yassan802/DRC-SerialSVMD2026.ver.0.2.1/README.md

STS3215等のシリアルバスサーボを動かすための基板。ver.0.1.2からの変更点としては、基板サイズが45*60mmになったこと、マイコンがRP2354Aになったこと、動力用電源に5Vを使用できることなどがあげられる。  
ver.0.1.2 → https://github.com/kotek-7/DRC-SerialSVMD2026/　　
スクリーンショット 2026-10-23 212213
