yassan802/DRC-SerialSVMD2026.ver.0.2.1/PCBA用BOM・CPL/bom.csv

Designator | Footprint | Quantity | Value | LCSC Part #
C19, C22, C24 | 0603 | 3 | 4.7uF | C19666
C20, C21 | 0402 | 2 | 15p | C1548
L1 | abracon_aota-b201610s3r3-101-t | 1 | AOTA-B201610S3R3-101-T | C42411119
Q1 | SOT-23-3 | 1 | MMBT3906 | C7420354
R1, R2 | 0603 | 2 | 27R | C25190
R3 | 0402 | 1 | 33R | C25105
R4 | 0402 | 1 | 1k | C11702
SW1, SW2 | SW_TS-1088-AR02016 | 2 | TS-1088-AR02016 | C720477
U2 | SOT-89-3 | 1 | 78L05G-AB3-R | C71136
U3 | SOIC-8_3.9x4.9mm_P1.27mm | 1 | Si8621EC-B-IS | C7010821
U5 | QFN-60-1EP_7x7mm_P0.4mm_EP3.4x3.4mm_ThermalVias | 1 | RP2354A | C41378174
U6 | SOIC-8_3.9x4.9mm_P1.27mm | 1 | SN65HVD230DR | C12084
Y1 | generic_xtalcc320x250x80-4 | 1 | ABM8-272-T3 | C20625731
