yassan802/DRC-SerialSVMD2026.ver.0.2.1/DRC-SerialSVMD2026.ver.0.2.1.pdf

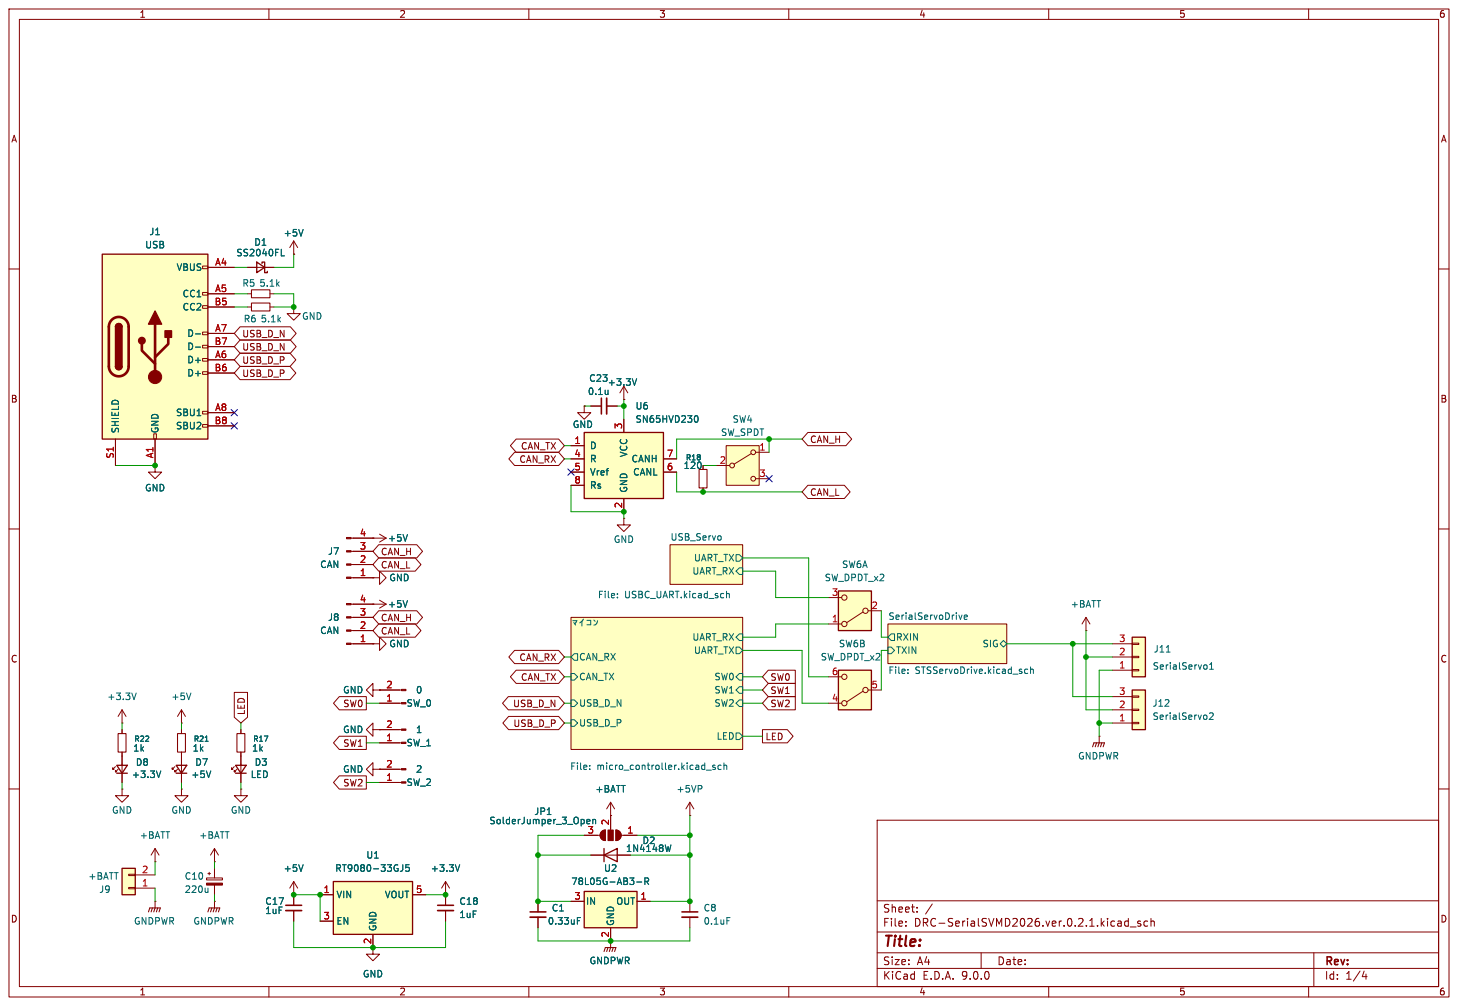
[picture p1: page 1]

Id: 1/4 Title: File: DRC-SerialSVMD2026.ver.0.2.1.kicad_sch Sheet: / RXIN

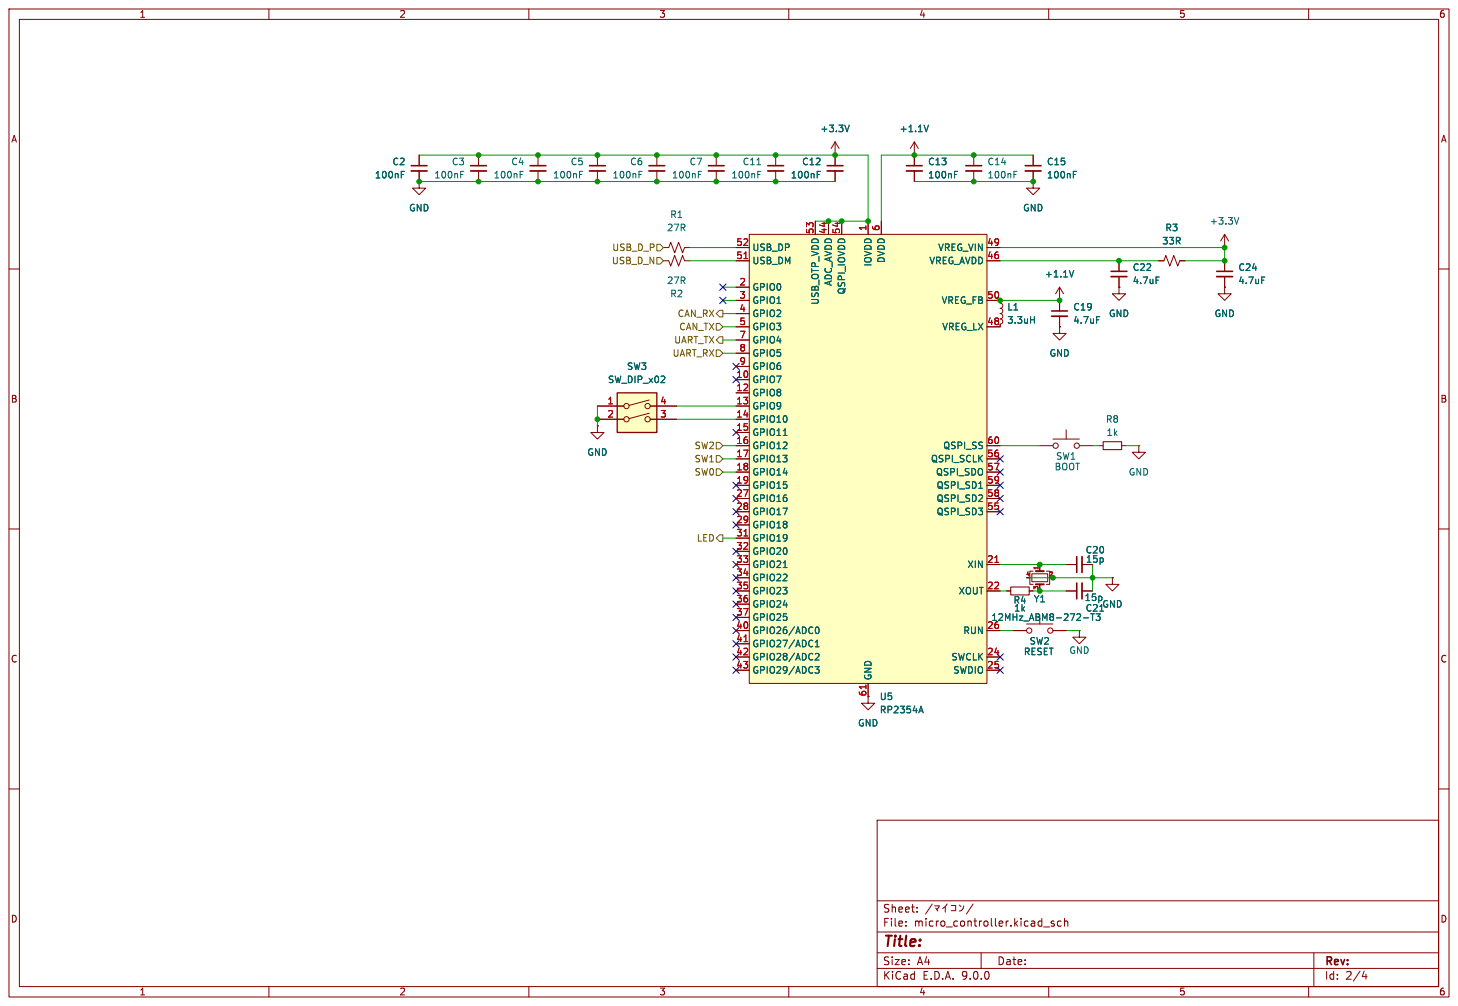
[picture p2: page 2]

Id: 2/4 Title: File: micro_controller.kicad_sch Sheet: þÿ/0Þ0¤0³0ó/ GND

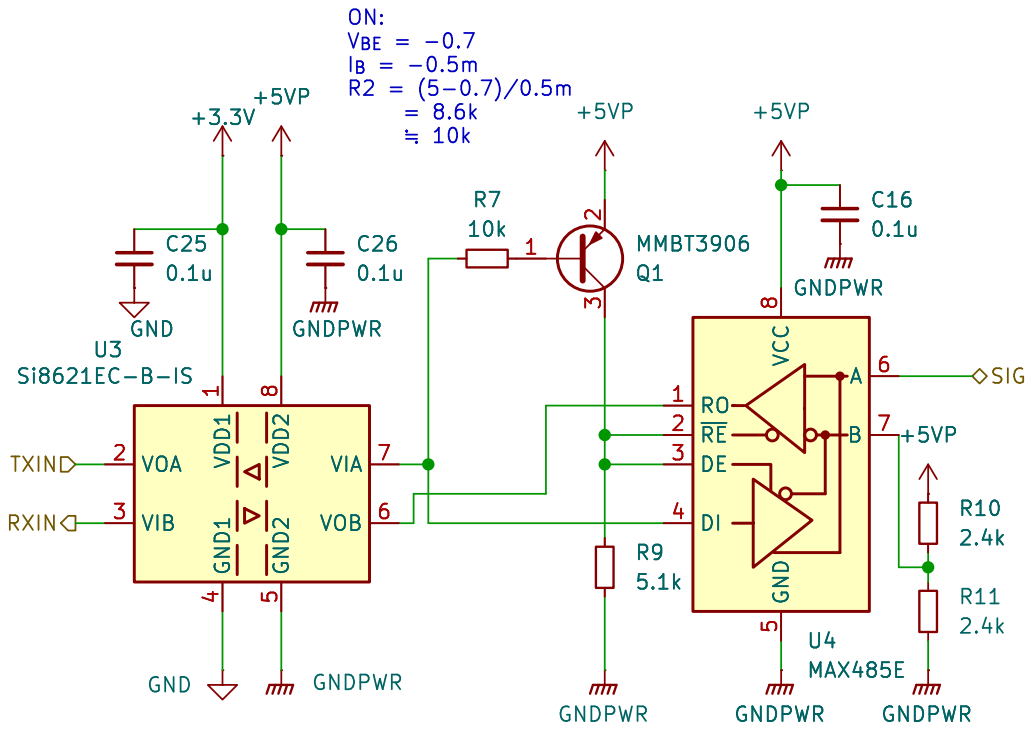
[picture p3: page 3]

3 2 U4 MAX485E RO 1 ~{RE} 2 DE 3 DI 4 VCC

5 VIA 7 VOB 6 U3 Si8621EC-B-IS GNDPWR

Id: 3/4 Title: File: STSServoDrive.kicad_sch Sheet: /SerialServoDrive/

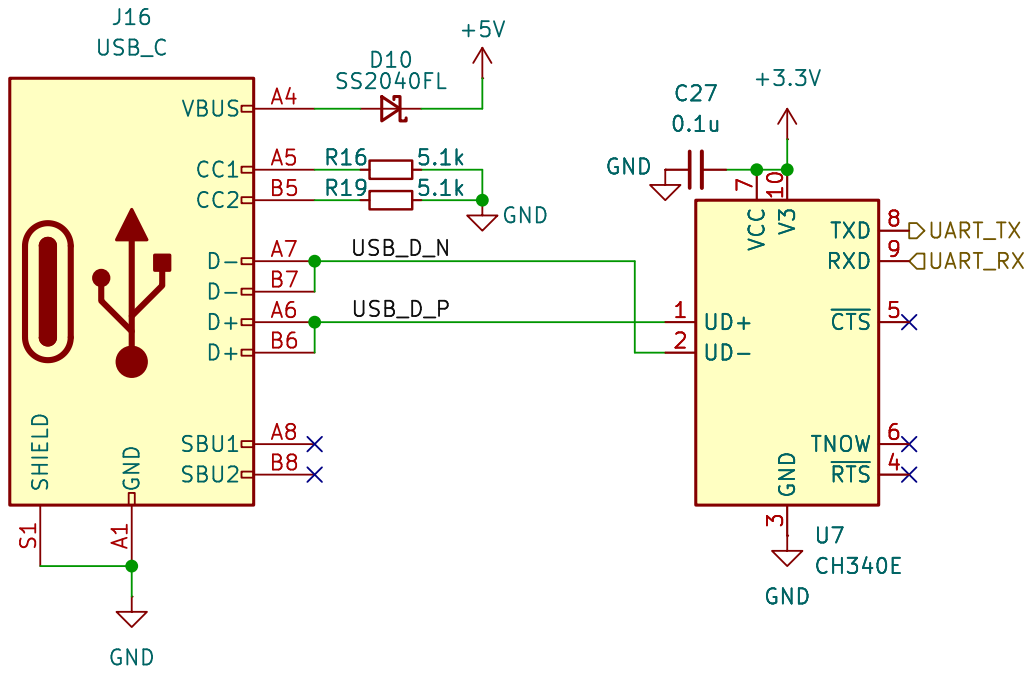
[picture p4: page 4]

3 TXD 8 RXD 9 ~{CTS}5 TNOW 6 ~{RTS}4 U7 CH340E R16 5.1k GND GND SHIELD S1 GND A1 VBUS A4 CC1 A5 CC2 B5 D- A7 D- B7 D+ A6 D+ B6 SBU1 A8 SBU2 B8

3 TXD 8 RXD 9 ~{CTS}5 TNOW 6 ~{RTS}4

Id: 4/4 Title: File: USBC_UART.kicad_sch Sheet: /USB_Servo/
