yassan802/DRC-SerialSVMD2026.ver.0.2.1/DRC-SerialSVMD2026.ver.0.2.1.kicad_pcb

## KiCad design DRC-SerialSVMD2026.ver.0.2.1.kicad_pcb (2026-10-23)

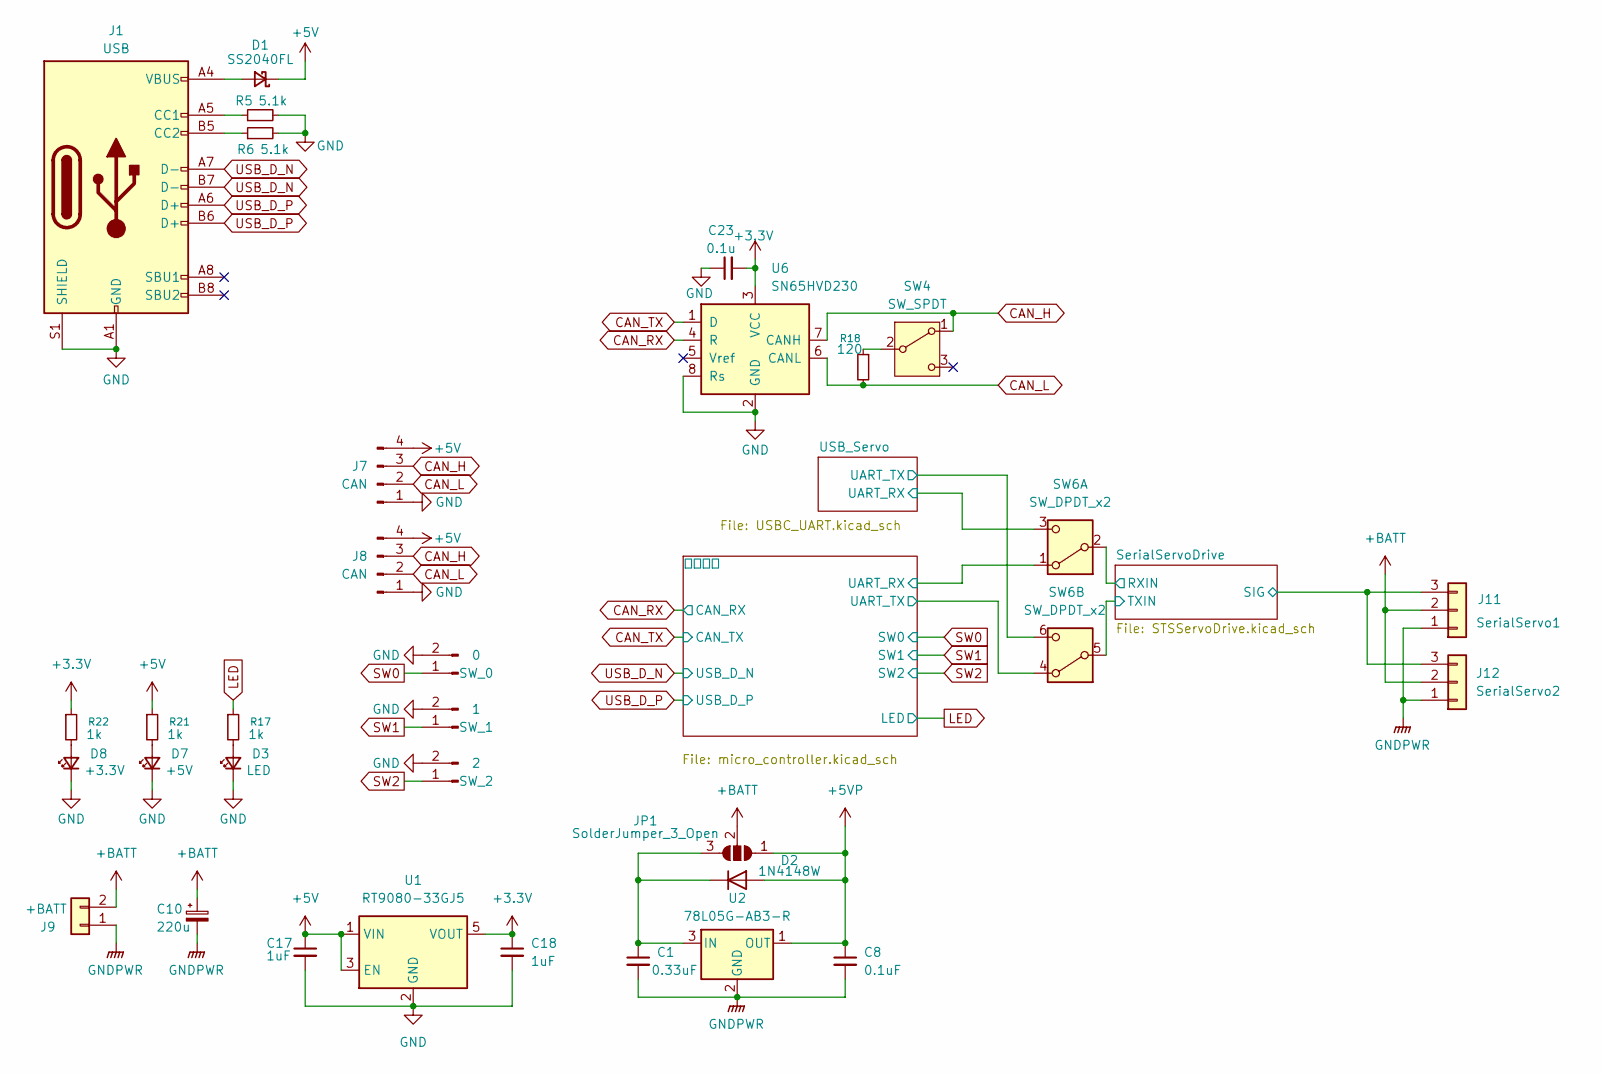
[picture p5: schematic DRC-SerialSVMD2026.ver.0.2.1.kicad_sch]

Parts:
C1: 0.33uF; C_0603_1608Metric_Pad1.08x0.95mm_HandSolder
C8: 0.1uF; C_0603_1608Metric_Pad1.08x0.95mm_HandSolder
C10: 220u; CP_Radial_D8.0mm_P3.50mm
C17, C18: 1uF; C_0603_1608Metric_Pad1.08x0.95mm_HandSolder
C23: 0.1u; C_0603_1608Metric_Pad1.08x0.95mm_HandSolder
D1: SS2040FL; D_SOD-123F
D2: 1N4148W; D_SOD-123
D3: LED; LED_0603_1608Metric_Pad1.05x0.95mm_HandSolder
D7: +5V; LED_0603_1608Metric_Pad1.05x0.95mm_HandSolder
D8: +3.3V; LED_0603_1608Metric_Pad1.05x0.95mm_HandSolder
J1: USB; USB_C_Receptacle_GCT_USB4105-xx-A_16P_TopMnt_Horizontal
J7, J8: CAN; JST_XH_S4B-XH-A_1x04_P2.50mm_Horizontal
J9: +BATT; AMASS_XT30PW-M_1x02_P2.50mm_Horizontal
J11: SerialServo1; JST_XH_S3B-XH-A_1x03_P2.50mm_Horizontal
J12: SerialServo2; JST_XH_S3B-XH-A_1x03_P2.50mm_Horizontal
JP1: SolderJumper_3_Open; SolderJumper-3_P1.3mm_Open_RoundedPad1.0x1.5mm_NumberLabels
R5, R6: 5.1k; R_0603_1608Metric_Pad0.98x0.95mm_HandSolder
R17, R21, R22: 1k; R_0603_1608Metric_Pad0.98x0.95mm_HandSolder
R18: 120; R_0603_1608Metric_Pad0.98x0.95mm_HandSolder
SW4: SW_SPDT; SW_Slide_SS-12D00G3_1P2T_P2.50mm
SW6: SW_DPDT_x2; IS-2235-G
SW_0: 0; JST_XH_B2B-XH-A_1x02_P2.50mm_Vertical
SW_1: 1; JST_XH_B2B-XH-A_1x02_P2.50mm_Vertical
SW_2: 2; JST_XH_B2B-XH-A_1x02_P2.50mm_Vertical
U1: RT9080-33GJ5; TSOT-23-5_HandSoldering
U2: 78L05G-AB3-R; SOT-89-3
U6: SN65HVD230; SOIC-8_3.9x4.9mm_P1.27mm

Connections:
+3.3V: C18.1, C23.2, R22.1, U1.5 (VOUT), U6.3 (VCC); also elsewhere on the board
+5V: C17.1, D1.1 (K), J7.4, J8.4, R21.1, U1.1 (VIN), U1.3 (EN); also elsewhere on the board
+5VP: C8.1, D2.2 (A), JP1.1 (A), U2.1 (OUT); also elsewhere on the board
+BATT: C10.1, J9.2, J11.2, J12.2, JP1.2 (C)
/SerialServoDrive/RXIN: SW6.2 (B); also elsewhere on the board
/SerialServoDrive/SIG: J11.3, J12.3; also elsewhere on the board
/SerialServoDrive/TXIN: SW6.5 (B); also elsewhere on the board
/USB_Servo/UART_RX: SW6.3 (C); also elsewhere on the board
/USB_Servo/UART_TX: SW6.6 (C); also elsewhere on the board
/マイコン/UART_RX: SW6.1 (A); also elsewhere on the board
/マイコン/UART_TX: SW6.4 (A); also elsewhere on the board
CAN_H: J7.3, J8.3, SW4.1 (A), U6.7 (CANH)
CAN_L: J7.2, J8.2, R18.2, U6.6 (CANL)
CAN_RX: U6.4 (R); also elsewhere on the board
CAN_TX: U6.1 (D); also elsewhere on the board
GND: C17.2, C18.2, C23.1, D3.1 (K), D7.1 (K), D8.1 (K), J1.A1 (GND), J1.A12 (GND), J1.B1 (GND), J1.B12 (GND), J1.S1 (SHIELD), J7.1, J8.1, R5.2, R6.2, SW_0.2, SW_1.2, SW_2.2, U1.2 (GND), U6.2 (GND), U6.8 (Rs); also elsewhere on the board
GNDPWR: C1.2, C8.2, C10.2, J9.1, J11.1, J12.1, U2.2 (GND); also elsewhere on the board
LED: R17.1; also elsewhere on the board
unnamed: D1.2 (A), J1.A4 (VBUS), J1.A9 (VBUS), J1.B4 (VBUS), J1.B9 (VBUS)
unnamed: C1.1, D2.1 (K), JP1.3 (B), U2.3 (IN)
unnamed: D3.2 (A), R17.2
unnamed: D7.2 (A), R21.2
unnamed: D8.2 (A), R22.2
unnamed: J1.A5 (CC1), R5.1
unnamed: J1.B5 (CC2), R6.1
unnamed: R18.1, SW4.2 (B)
SW0: SW_0.1; also elsewhere on the board
SW1: SW_1.1; also elsewhere on the board
SW2: SW_2.1; also elsewhere on the board
USB_D_N: J1.A7 (D-), J1.B7 (D-); also elsewhere on the board
USB_D_P: J1.A6 (D+), J1.B6 (D+); also elsewhere on the board

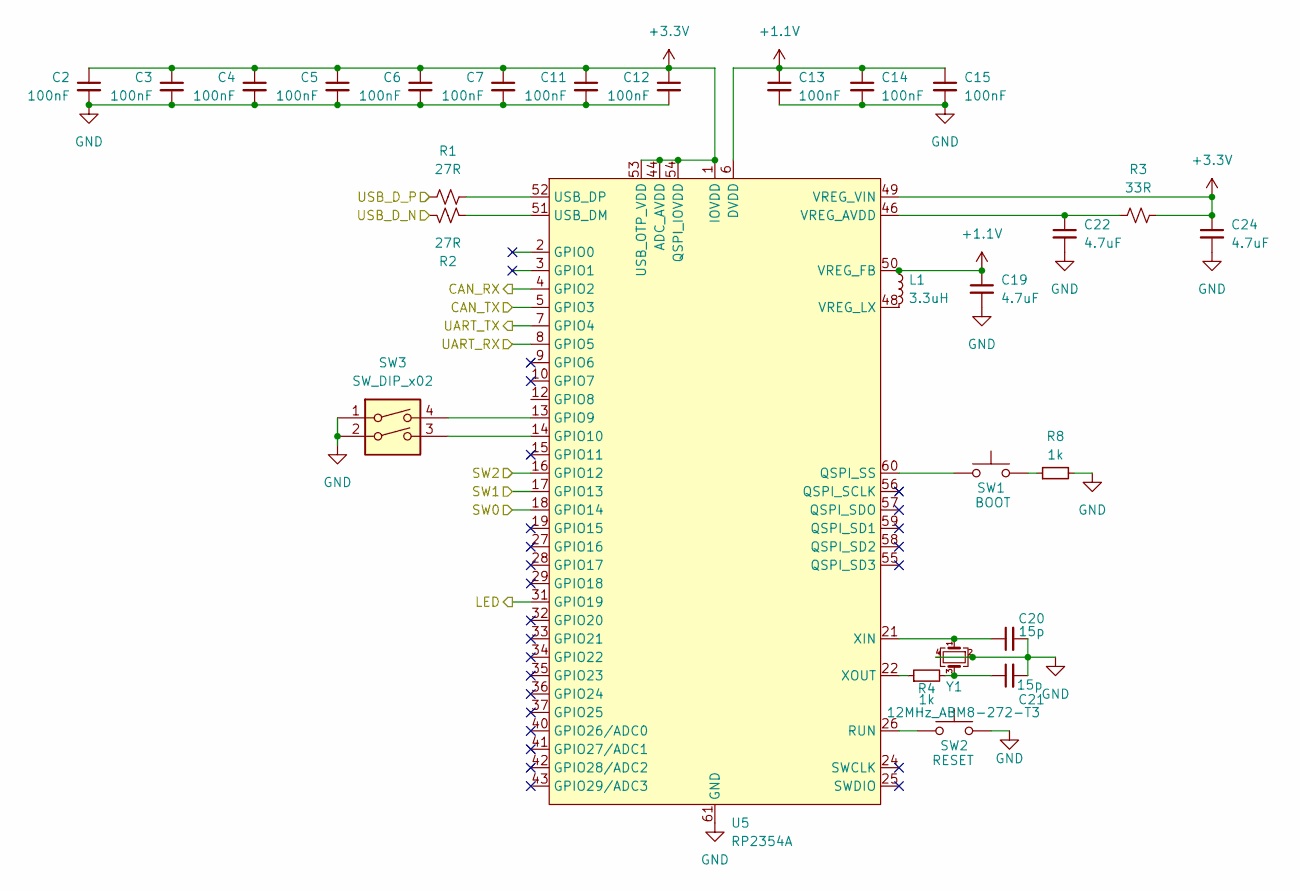
[picture p6: schematic micro_controller.kicad_sch]

Parts:
C2, C3, C4, C5, C6, C7, C11, C12, C13, C14, C15: 100nF; C_0603_1608Metric_Pad1.08x0.95mm_HandSolder
C19, C22, C24: 4.7uF; C_0603_1608Metric
C20, C21: 15p; C_0402_1005Metric
L1: 3.3uH; abracon_aota-b201610s3r3-101-t
R1, R2: 27R; R_0603_1608Metric
R3: 33R; R_0402_1005Metric
R4: 1k; R_0402_1005Metric
R8: 1k; R_0603_1608Metric_Pad0.98x0.95mm_HandSolder
SW1: BOOT; SW_TS-1088-AR02016
SW2: RESET; SW_TS-1088-AR02016
SW3: SW_DIP_x02; SW_DIP_SPSTx02_Slide_KingTek_DSHP02TS_W7.62mm_P1.27mm
U5: RP2354A; QFN-60-1EP_7x7mm_P0.4mm_EP3.4x3.4mm_ThermalVias
Y1: 12MHz_ABM8-272-T3; generic_xtalcc320x250x80-4

Connections:
+1.1V: C13.1, C14.1, C15.1, C19.1, L1.1, U5.6 (DVDD), U5.23 (DVDD), U5.39 (DVDD), U5.50 (VREG_FB)
+3.3V: C2.1, C3.1, C4.1, C5.1, C6.1, C7.1, C11.1, C12.1, C24.1, R3.2, U5.1 (IOVDD), U5.11 (IOVDD), U5.20 (IOVDD), U5.30 (IOVDD), U5.38 (IOVDD), U5.44 (ADC_AVDD), U5.45 (IOVDD), U5.49 (VREG_VIN), U5.53 (USB_OTP_VDD), U5.54 (QSPI_IOVDD); also elsewhere on the board
/マイコン/UART_RX: U5.8 (GPIO5); also elsewhere on the board
/マイコン/UART_TX: U5.7 (GPIO4); also elsewhere on the board
CAN_RX: U5.4 (GPIO2); also elsewhere on the board
CAN_TX: U5.5 (GPIO3); also elsewhere on the board
GND: C2.2, C3.2, C4.2, C5.2, C6.2, C7.2, C11.2, C12.2, C13.2, C14.2, C15.2, C19.2, C20.2, C21.2, C22.2, C24.2, R8.2, SW2.1, SW3.1, SW3.2, U5.47 (VREG_PGND), U5.61 (GND), Y1.2, Y1.4; also elsewhere on the board
LED: U5.31 (GPIO19); also elsewhere on the board
unnamed: C21.1, R4.2, Y1.3
unnamed: R8.1, SW1.1
unnamed: SW3.4, U5.13 (GPIO9)
unnamed: SW3.3, U5.14 (GPIO10)
unnamed: SW1.2, U5.60 (QSPI_SS)
unnamed: SW2.2, U5.26 (RUN)
unnamed: R2.2, U5.51 (USB_DM)
unnamed: R1.2, U5.52 (USB_DP)
unnamed: C22.1, R3.1, U5.46 (VREG_AVDD)
unnamed: L1.2, U5.48 (VREG_LX)
unnamed: C20.1, U5.21 (XIN), Y1.1
unnamed: R4.1, U5.22 (XOUT)
SW0: U5.18 (GPIO14); also elsewhere on the board
SW1: U5.17 (GPIO13); also elsewhere on the board
SW2: U5.16 (GPIO12); also elsewhere on the board
USB_D_N: R2.1; also elsewhere on the board
USB_D_P: R1.1; also elsewhere on the board

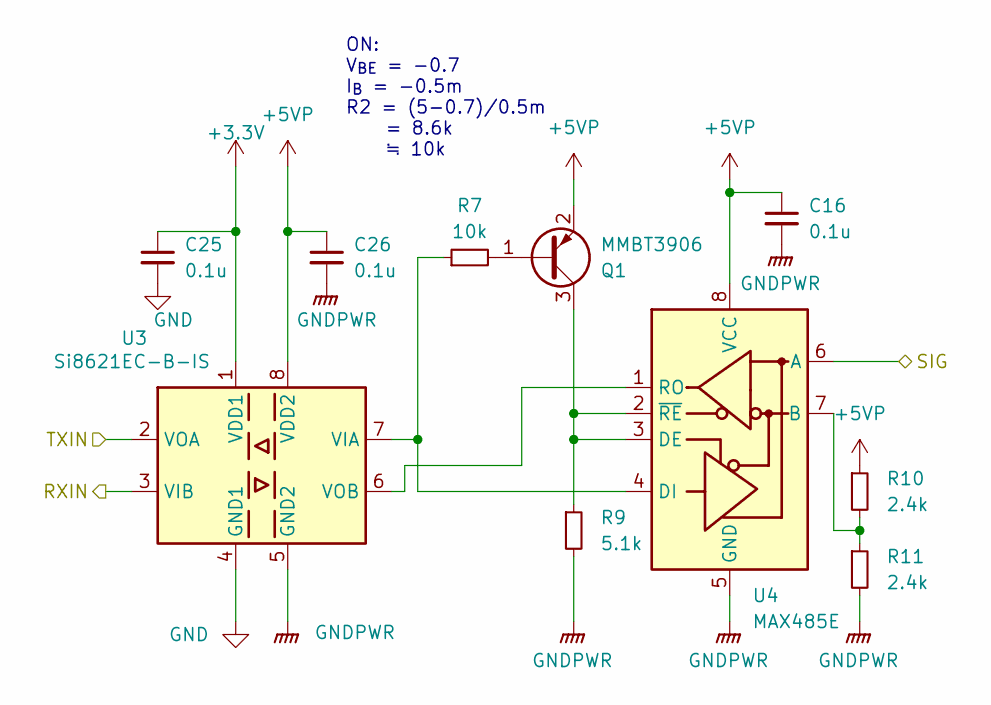
[picture p7: schematic STSServoDrive.kicad_sch]

Parts:
C16, C25, C26: 0.1u; C_0603_1608Metric_Pad1.08x0.95mm_HandSolder
Q1: MMBT3906; SOT-23-3; LCSC x
R7: 10k; R_0603_1608Metric_Pad0.98x0.95mm_HandSolder
R9: 5.1k; R_0603_1608Metric_Pad0.98x0.95mm_HandSolder
R10, R11: 2.4k; R_0603_1608Metric_Pad0.98x0.95mm_HandSolder
U3: Si8621EC-B-IS; SOIC-8_3.9x4.9mm_P1.27mm
U4: MAX485E; SOIC-8_3.9x4.9mm_P1.27mm

Connections:
+3.3V: C25.1, U3.1 (VDD1); also elsewhere on the board
+5VP: C16.1, C26.1, Q1.2 (E), R10.1, U3.8 (VDD2), U4.8 (VCC); also elsewhere on the board
/SerialServoDrive/RXIN: U3.3 (VIB); also elsewhere on the board
/SerialServoDrive/SIG: U4.6 (A); also elsewhere on the board
/SerialServoDrive/TXIN: U3.2 (VOA); also elsewhere on the board
GND: C25.2, U3.4 (GND1); also elsewhere on the board
GNDPWR: C16.2, C26.2, R9.2, R11.2, U3.5 (GND2), U4.5 (GND); also elsewhere on the board
unnamed: Q1.1 (B), R7.2
unnamed: Q1.3 (C), R9.1, U4.2 (~RE), U4.3 (DE)
unnamed: R7.1, U3.7 (VIA), U4.4 (DI)
unnamed: U3.6 (VOB), U4.1 (RO)
unnamed: R10.2, R11.1, U4.7 (B)

Notes on the sheet:
ON: V_{BE} = -0.7 I_{B} = -0.5m R2 = (5-0.7)/0.5m = 8.6k ≒ 10k

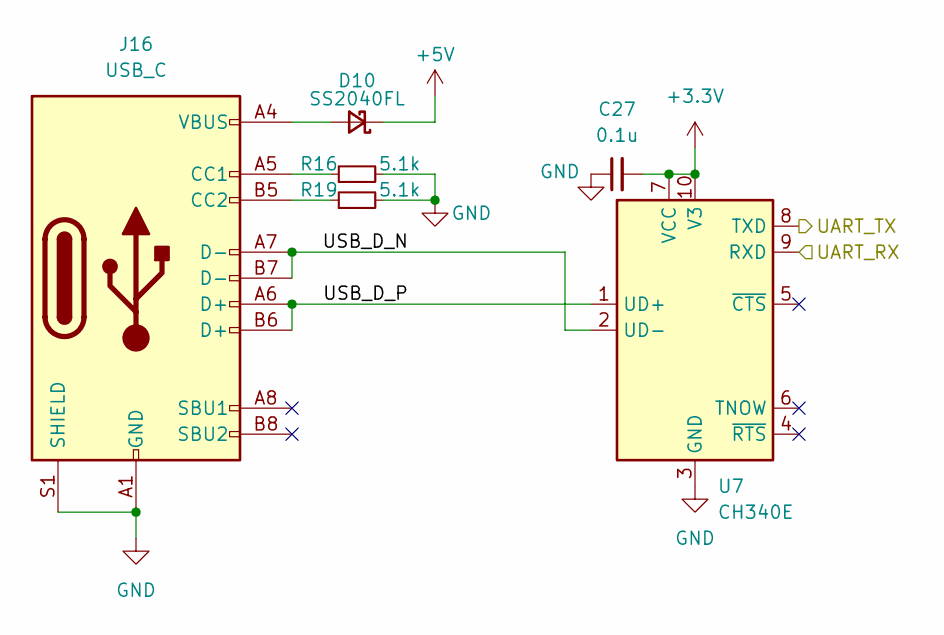
[picture p8: schematic USBC_UART.kicad_sch]

Parts:
C27: 0.1u; C_0603_1608Metric_Pad1.08x0.95mm_HandSolder
D10: SS2040FL; D_SOD-123F
J16: USB_C; USB_C_Receptacle_GCT_USB4105-xx-A_16P_TopMnt_Horizontal
R16, R19: 5.1k; R_0603_1608Metric_Pad0.98x0.95mm_HandSolder
U7: CH340E; MSOP-10_3x3mm_P0.5mm

Connections:
+3.3V: C27.2, U7.7 (VCC), U7.10 (V3); also elsewhere on the board
+5V: D10.1 (K); also elsewhere on the board
/USB_Servo/UART_RX: U7.9 (RXD); also elsewhere on the board
/USB_Servo/UART_TX: U7.8 (TXD); also elsewhere on the board
/USB_Servo/USB_D_N: J16.A7 (D-), J16.B7 (D-), U7.2 (UD-)
/USB_Servo/USB_D_P: J16.A6 (D+), J16.B6 (D+), U7.1 (UD+)
GND: C27.1, J16.A1 (GND), J16.A12 (GND), J16.B1 (GND), J16.B12 (GND), J16.S1 (SHIELD), R16.2, R19.2, U7.3 (GND); also elsewhere on the board
unnamed: D10.2 (A), J16.A4 (VBUS), J16.A9 (VBUS), J16.B4 (VBUS), J16.B9 (VBUS)
unnamed: J16.A5 (CC1), R16.1
unnamed: J16.B5 (CC2), R19.1

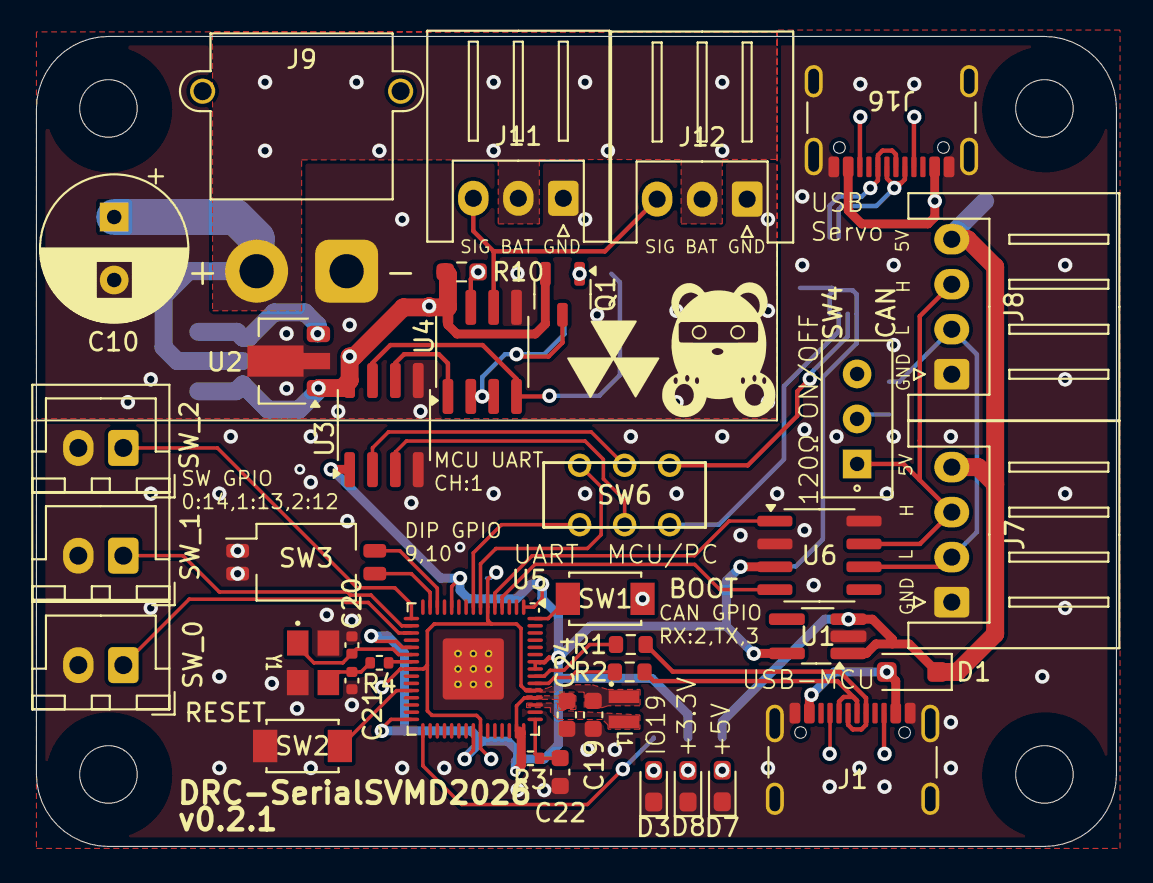
[picture p9: board DRC-SerialSVMD2026.ver.0.2.1.kicad_pcb from above]

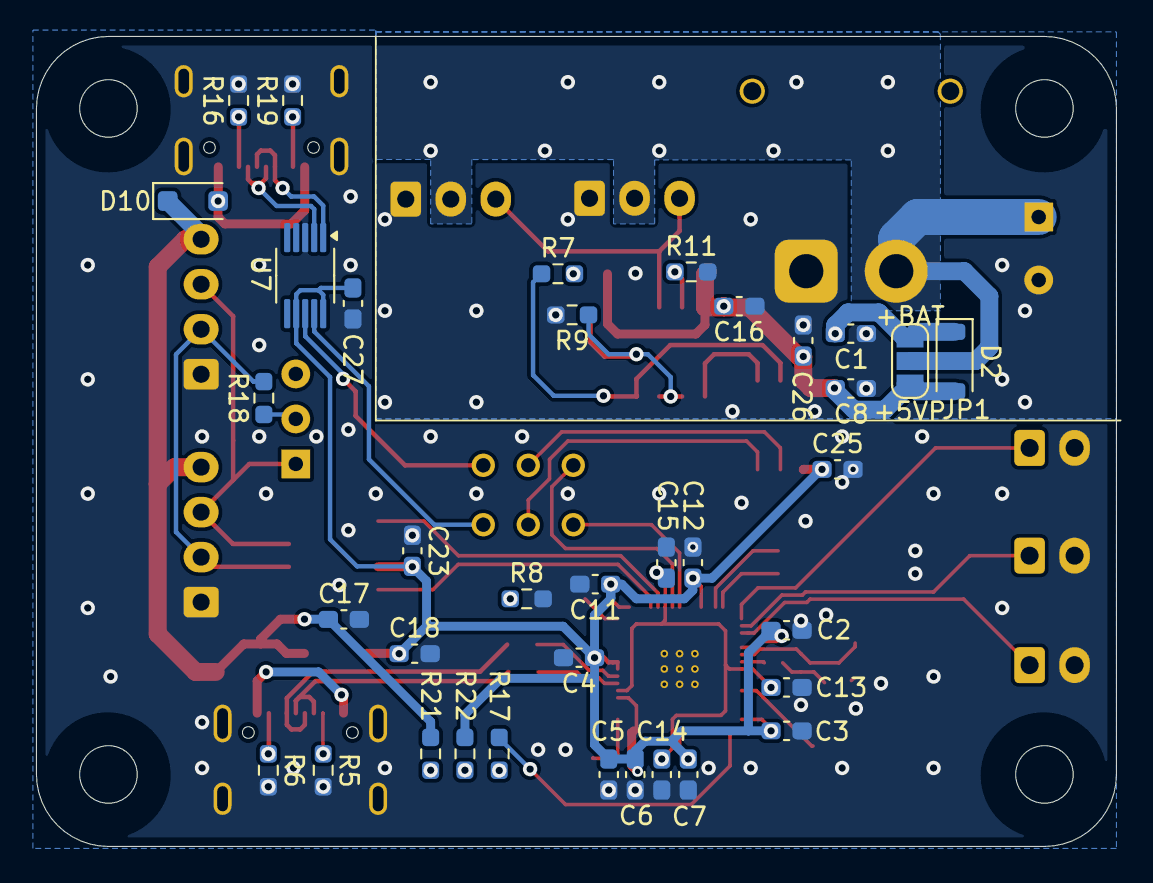
[picture p10: board DRC-SerialSVMD2026.ver.0.2.1.kicad_pcb from below]

Board: 2 copper layers, 60.0 x 45.0 mm, 75 parts (36 on the bottom side), 54 nets.
