yassan802/DRC-SerialSVMD2026.ver.0.2.1/(commit log)

2026-10-22 Initial KiCad project
2026-10-23 Update board design and PCBA manufacturing files
2026-10-23 Add details about board version 0.1.2 changes
    Updated README to reflect changes in board specifications and microcontroller.
2026-10-23 Update PCB layout
2026-10-23 Update PCB silkscreen placement
